robert-str/kicad_lib/struktura katalogu biblioteki.png

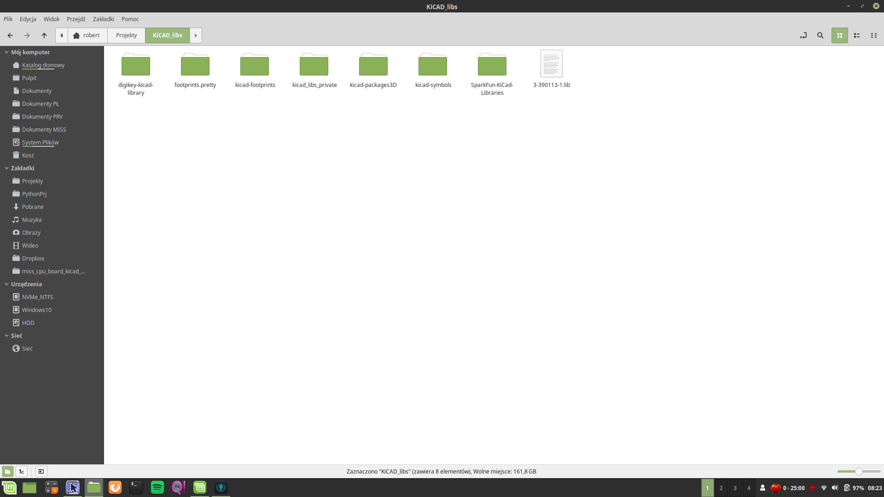
struktura katalogu biblioteki.png
