robert-str/kicad_lib/STEPs/TFBGA24025.step

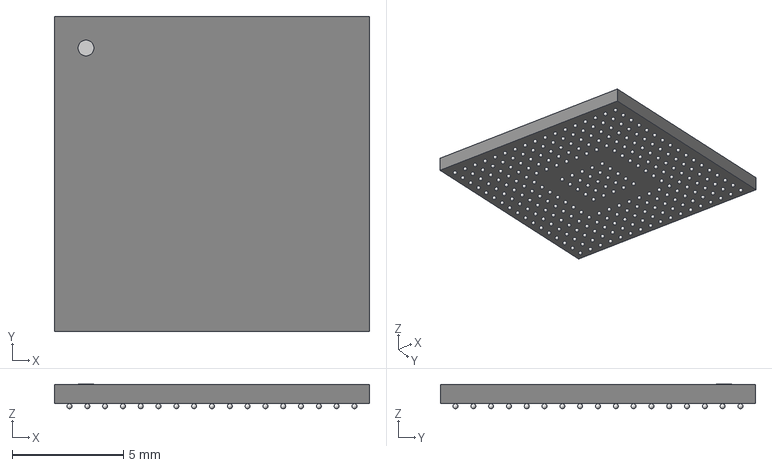
[picture p2: CAD file, 2022-11-16]
STEPs/TFBGA24025.step
14.1 x 14.1 x 1.10 mm
