robert-str/kicad_lib/STEPs/c-640456-5-aa-3d.stp

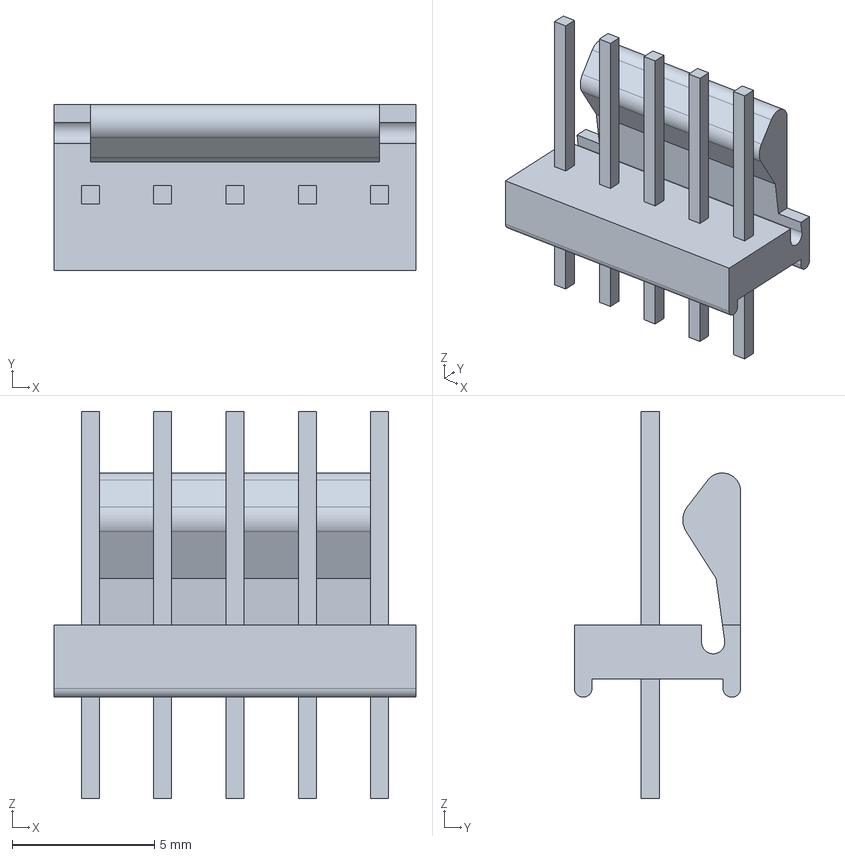
[picture p3: CAD file, 2022-11-16]
STEPs/c-640456-5-aa-3d.stp
12.7 x 5.84 x 13.6 mm
