robert-str/kicad_lib/STEPs/microphone_6mm_smt_h3i5mm.stp

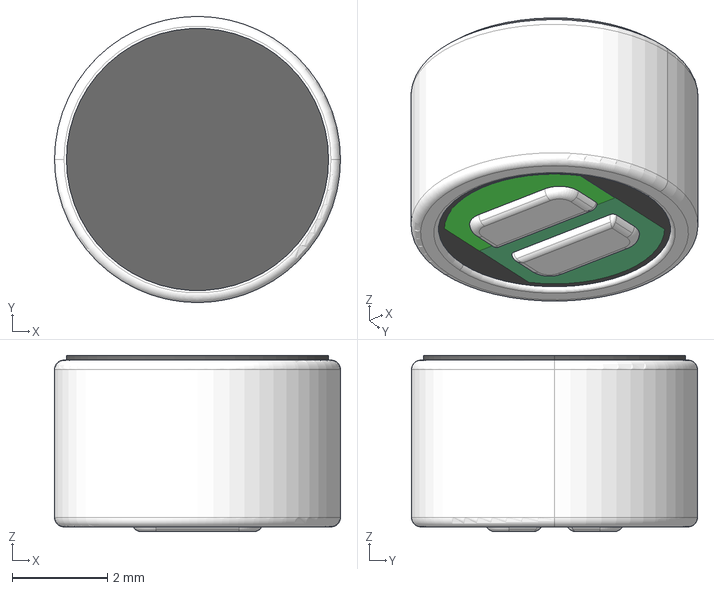
[picture p4: CAD file, 2022-11-16]
STEPs/microphone_6mm_smt_h3i5mm.stp
6.00 x 6.00 x 3.70 mm
