robert-str/kicad_lib/STEPs/QFN48_L-ASC10_ICE40ULTRA_PLUS__MACHXO2_LAT.step

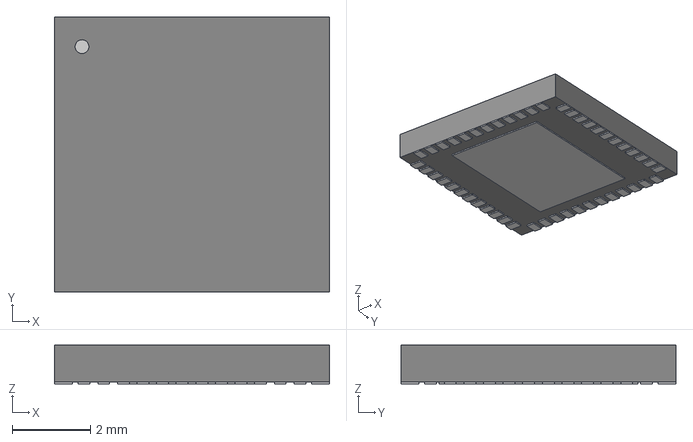
[picture p5: CAD file, 2022-11-16]
STEPs/QFN48_L-ASC10_ICE40ULTRA_PLUS__MACHXO2_LAT.step
7.01 x 7.01 x 0.993 mm
