robert-str/kicad_lib/STEPs/BRX1-0001.STEP

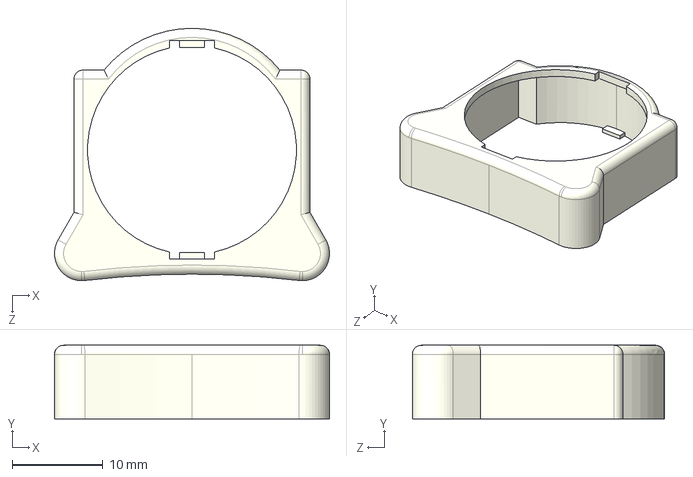
[picture p6: CAD file, 2022-11-16]
STEPs/BRX1-0001.STEP
30.3 x 8.10 x 27.8 mm
