robert-str/kicad_lib/STEPs/Crystal_ECX-32_3i2x2i5x0i8.STEP

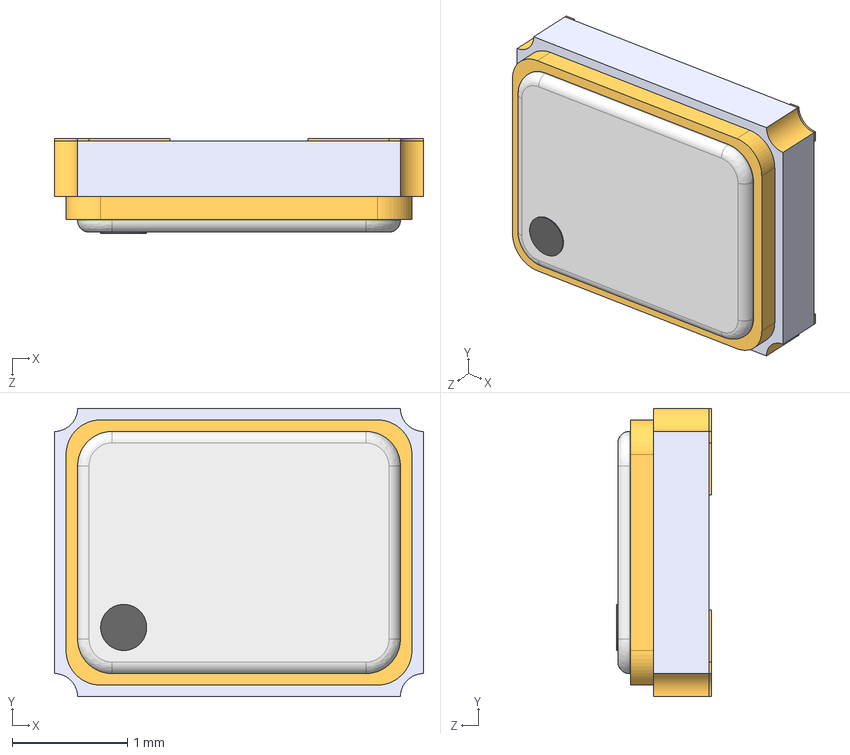
[picture p7: CAD file, 2022-11-16]
STEPs/Crystal_ECX-32_3i2x2i5x0i8.STEP
3.20 x 2.50 x 0.82 mm
MetalFrame
Pin1Marker
Pin3
Pin1
Lid
Pin4
Pin2
Ceramic
