robert-str/kicad_lib/STEPs/ASE_series _ABRACON.step

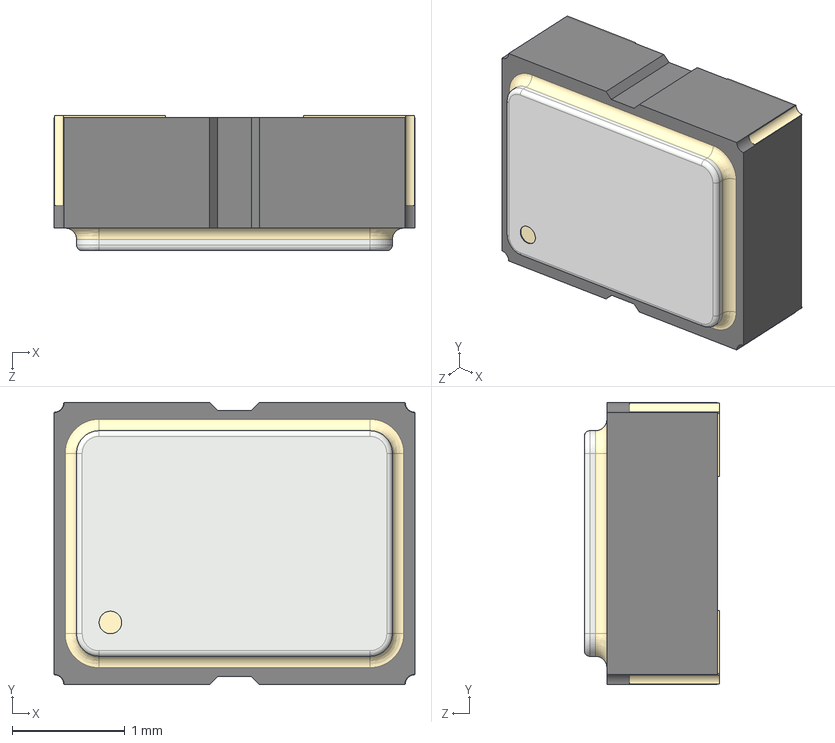
[picture p8: CAD file, 2022-11-16]
STEPs/ASE_series _ABRACON.step
3.20 x 2.50 x 1.20 mm
