robert-str/kicad_lib/STEPs/08B0-1X1T-06-F.step

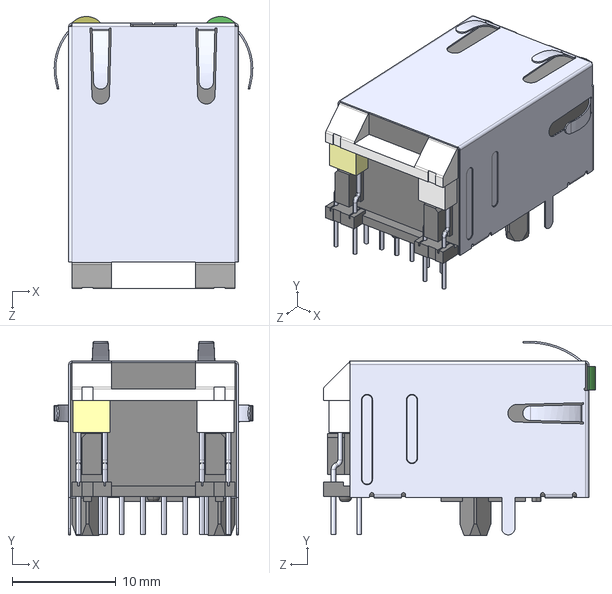
[picture p9: CAD file, 2022-11-16]
STEPs/08B0-1X1T-06-F.step
19.1 x 18.7 x 26.2 mm
