robert-str/kicad_lib/STEPs/BRX1-2477-SM.STEP

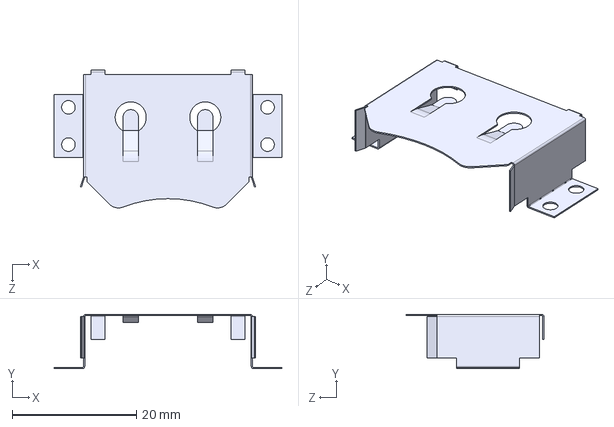
[picture p10: CAD file, 2022-07-14]
STEPs/BRX1-2477-SM.STEP
36.7 x 8.70 x 22.2 mm
