robert-str/kicad_lib/STEPs/Fuse_1812.step

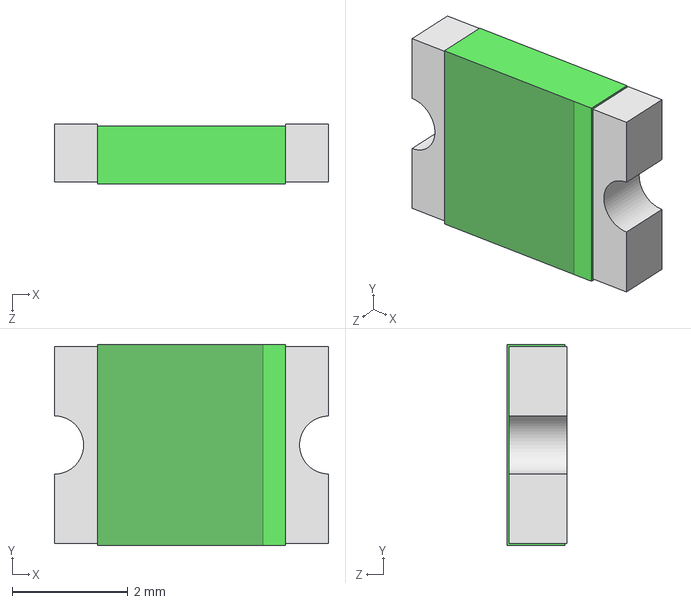
[picture p11: CAD file, 2022-07-14]
STEPs/Fuse_1812.step
4.74 x 3.48 x 1.04 mm
