robert-str/kicad_lib/STEPs/SOD-128_ST214.step

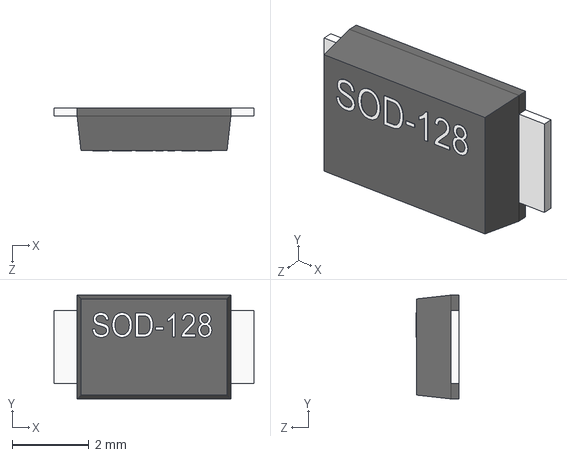
[picture p12: CAD file, 2022-07-14]
STEPs/SOD-128_ST214.step
5.20 x 2.70 x 1.11 mm
