robert-str/kicad_lib/STEPs/c-640456-2-aa-3d.stp

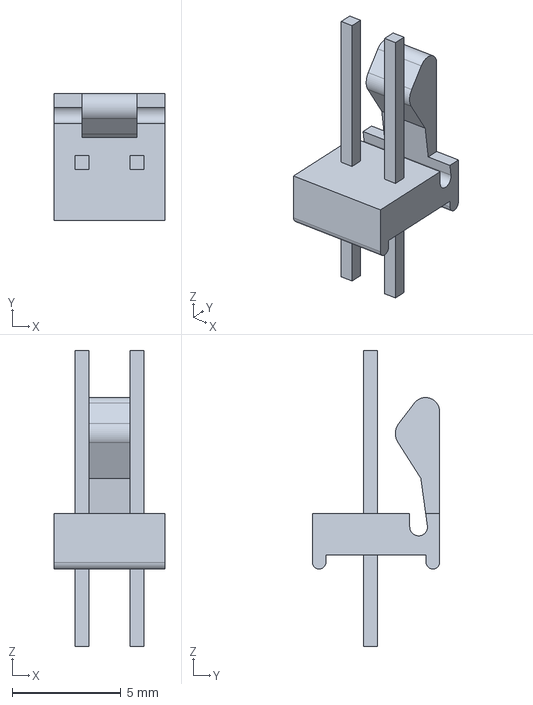
[picture p13: CAD file, 2022-07-14]
STEPs/c-640456-2-aa-3d.stp
5.08 x 5.84 x 13.6 mm
