robert-str/kicad_lib/STEPs/Coilcraft-MSS1210.step

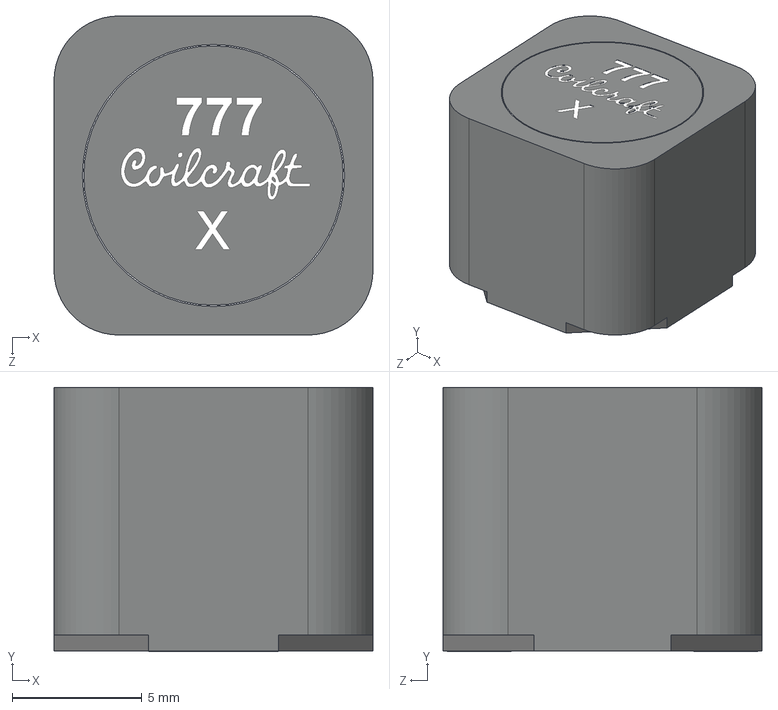
[picture p14: CAD file, 2022-07-14]
STEPs/Coilcraft-MSS1210.step
12.3 x 10.2 x 12.3 mm
