robert-str/kicad_lib/STEPs/CP_Elec_12.5x14_86508xx620xx (rev1).stp

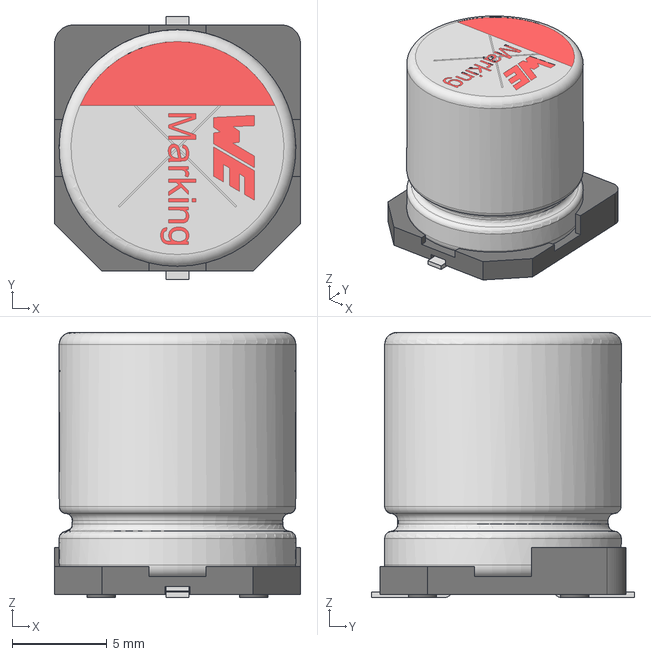
[picture p15: CAD file, 2022-07-14]
STEPs/CP_Elec_12.5x14_86508xx620xx (rev1).stp
13.0 x 13.9 x 14.0 mm
Base_Φ13Capacitor
capicitor_12.5x14x4.5
