robert-str/kicad_lib/STEPs/ABS09.STEP

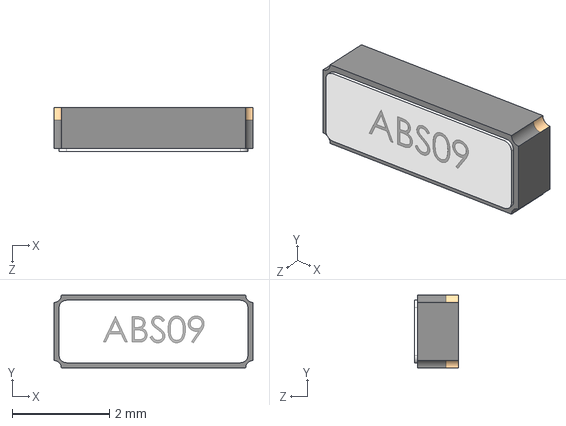
[picture p16: CAD file, 2022-05-02]
STEPs/ABS09.STEP
4.10 x 1.50 x 0.9 mm
