robert-str/kicad_lib/STEPs/XF3M_1015_1B.STEP

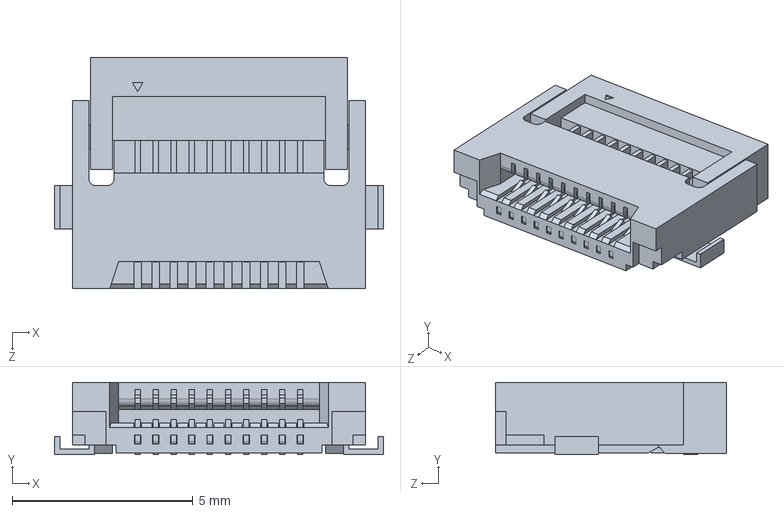
[picture p17: CAD file, 2022-05-02]
STEPs/XF3M_1015_1B.STEP
9.10 x 2.00 x 6.40 mm
