robert-str/kicad_lib/STEPs/XF2M_4015_1A.step

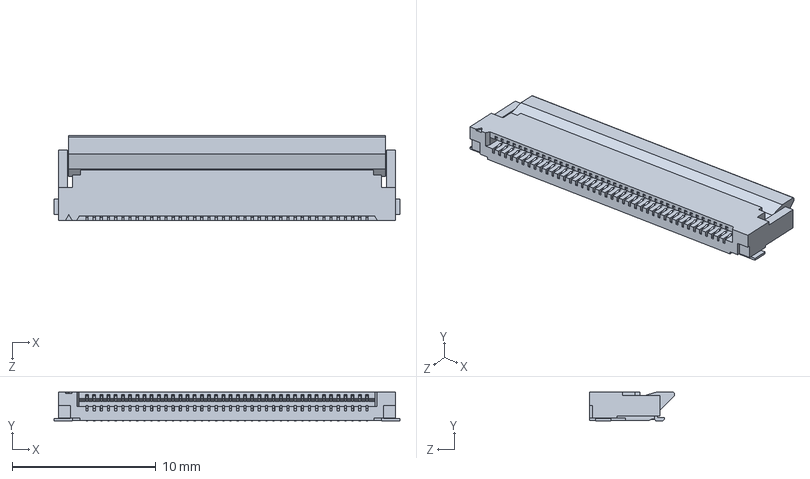
[picture p18: CAD file, 2022-05-02]
STEPs/XF2M_4015_1A.step
24.1 x 2.00 x 5.90 mm
