robert-str/kicad_lib/STEPs/XF2M_1015_1A.step

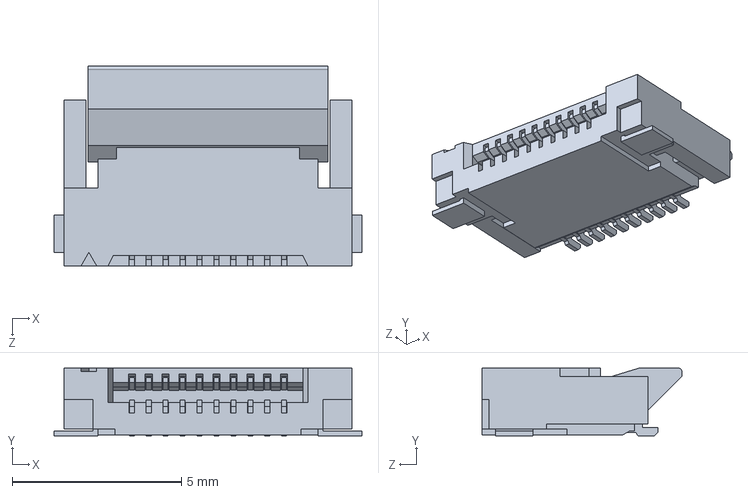
[picture p19: CAD file, 2022-05-02]
STEPs/XF2M_1015_1A.step
9.10 x 2.00 x 5.90 mm
