robert-str/kicad_lib/STEPs/OMRON B3U1000P.step

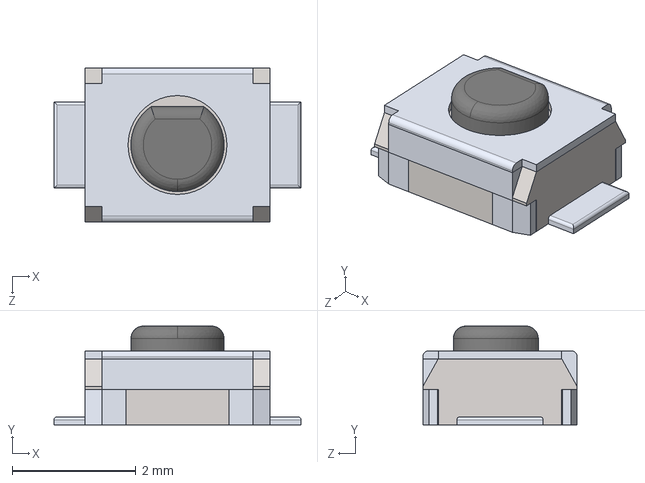
[picture p20: CAD file, 2021-01-22]
STEPs/OMRON B3U1000P.step
4.00 x 1.60 x 2.50 mm
