robert-str/kicad_lib/STEPs/MDBT50Q-U 3D Drawing_20180620.stp

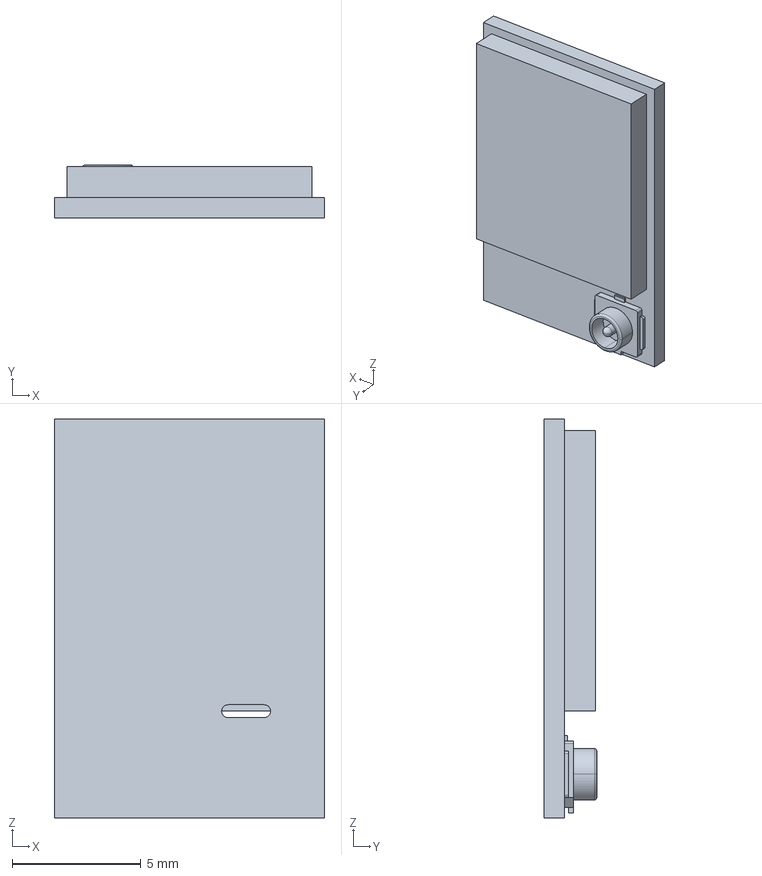
[picture p21: CAD file, 2019-12-09]
STEPs/MDBT50Q-U 3D Drawing_20180620.stp
10.5 x 2.05 x 15.5 mm
