robert-str/kicad_lib/STEPs/TSR-1.step

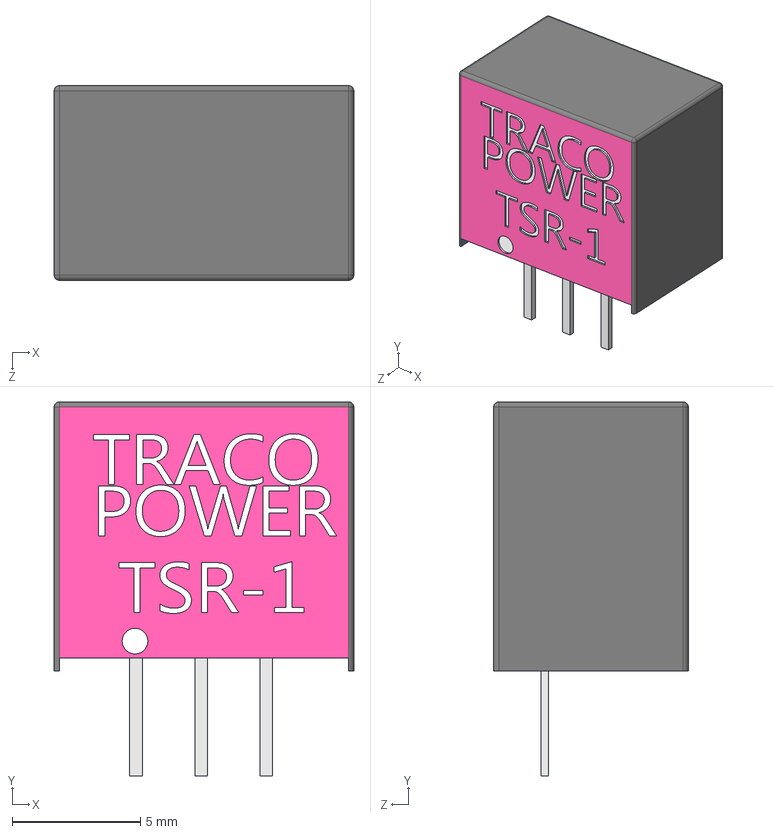
[picture p22: CAD file, 2019-12-09]
STEPs/TSR-1.step
11.7 x 14.6 x 7.60 mm
