robert-str/kicad_lib/STEPs/TSR-2.step

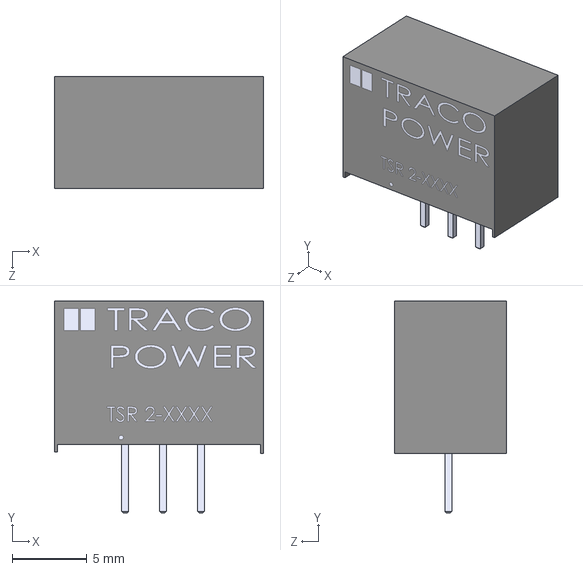
[picture p23: CAD file, 2019-12-09]
STEPs/TSR-2.step
14.0 x 14.2 x 7.50 mm
