robert-str/kicad_lib/STEPs/KEYSTONE 2460.step

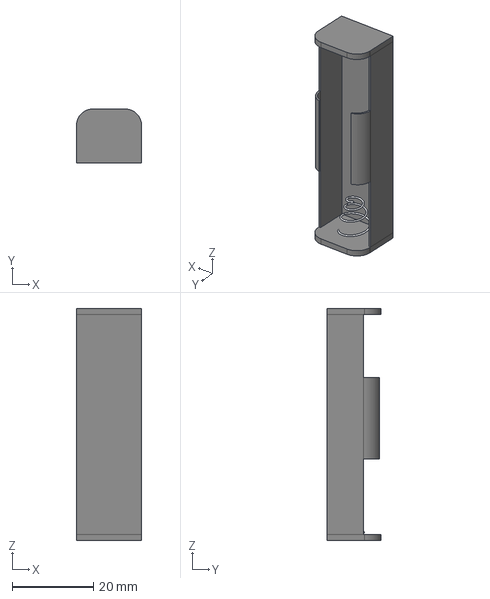
[picture p24: CAD file, 2019-12-09]
STEPs/KEYSTONE 2460.step
16.0 x 13.3 x 57.0 mm
