robert-str/kicad_lib/STEPs/SM1X91_body.stp

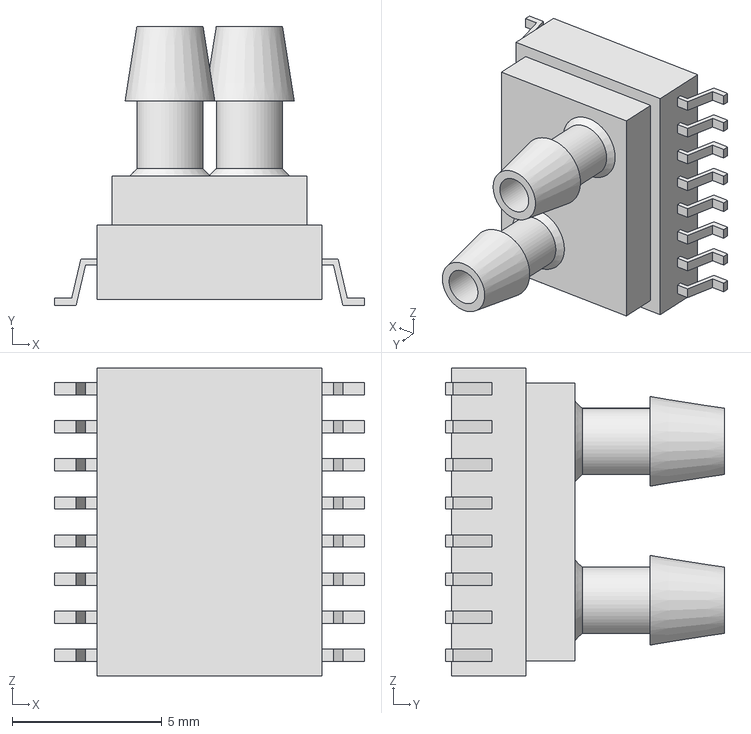
[picture p25: CAD file, 2019-12-09]
STEPs/SM1X91_body.stp
10.3 x 9.32 x 10.3 mm
