robert-str/kicad_lib/STEPs/RJHSE-X38X-REVT1.STEP

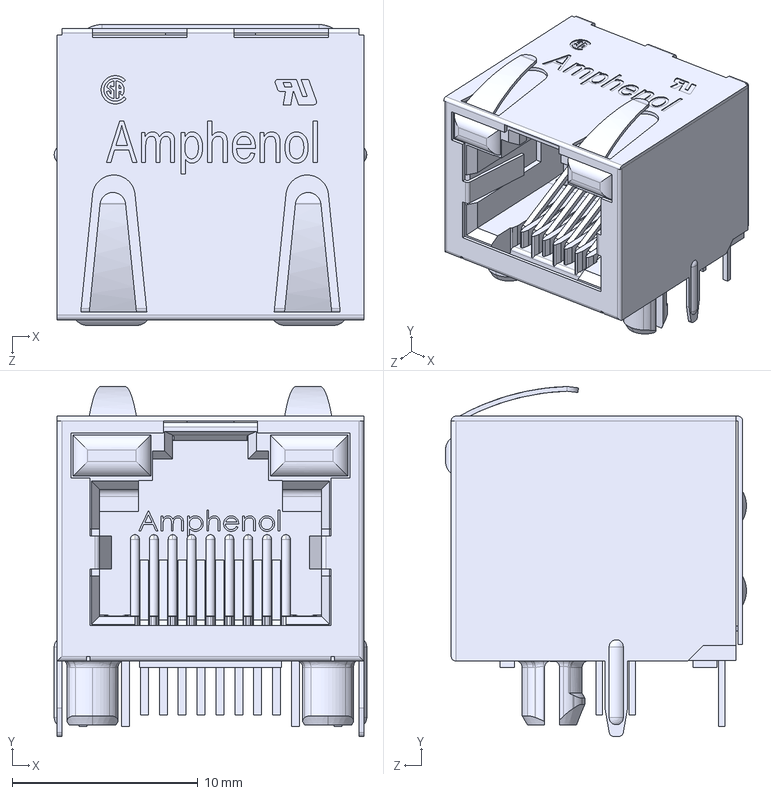
[picture p26: CAD file, 2019-11-26]
STEPs/RJHSE-X38X-REVT1.STEP
16.8 x 18.8 x 16.2 mm
