robert-str/kicad_lib/STEPs/MX-48037-0001.STEP

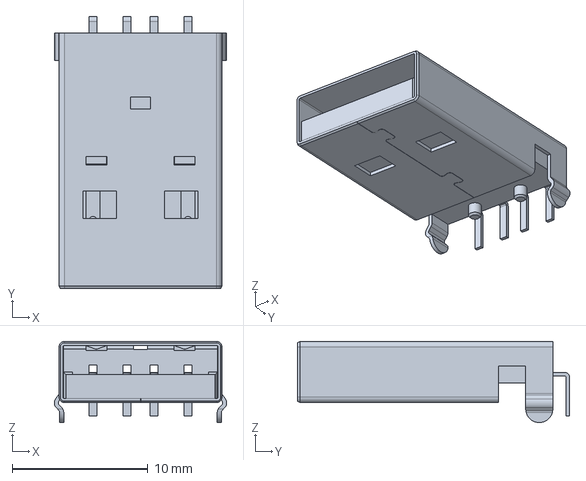
[picture p27: CAD file, 2019-11-26]
STEPs/MX-48037-0001.STEP
12.7 x 20.0 x 5.97 mm
