robert-str/kicad_lib/STEPs/Conn_Pancon_MLSS100-2-D_eec.STEP

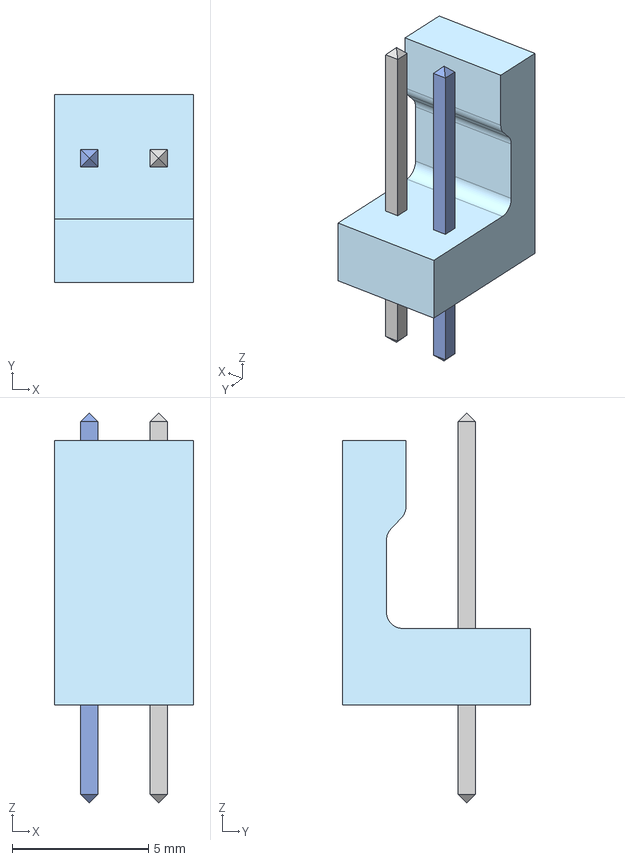
[picture p28: CAD file, 2019-11-14]
STEPs/Conn_Pancon_MLSS100-2-D_eec.STEP
5.10 x 6.90 x 14.3 mm
