robert-str/kicad_lib/STEPs/UE27-AEX4-X0X-REVT2.STEP

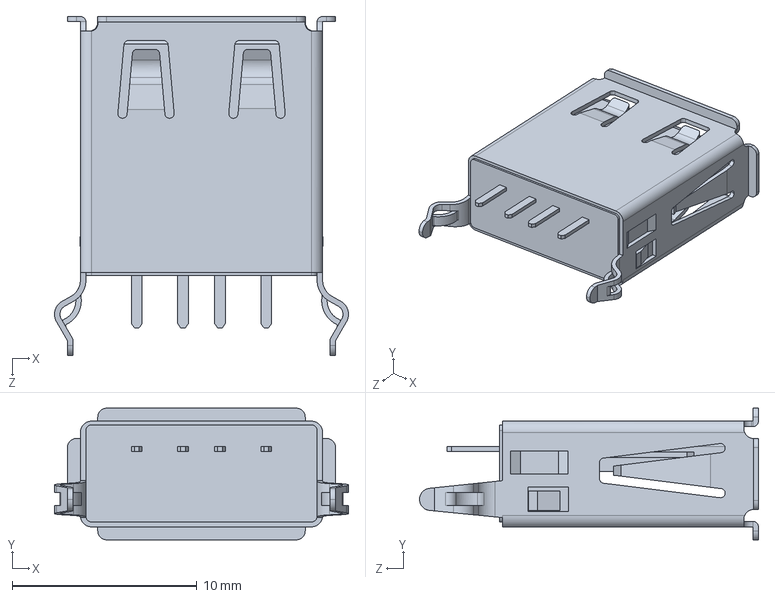
[picture p29: CAD file, 2019-11-14]
STEPs/UE27-AEX4-X0X-REVT2.STEP
15.9 x 7.12 x 18.3 mm
