robert-str/kicad_lib/STEPs/DG300-5_0-02P-12.step

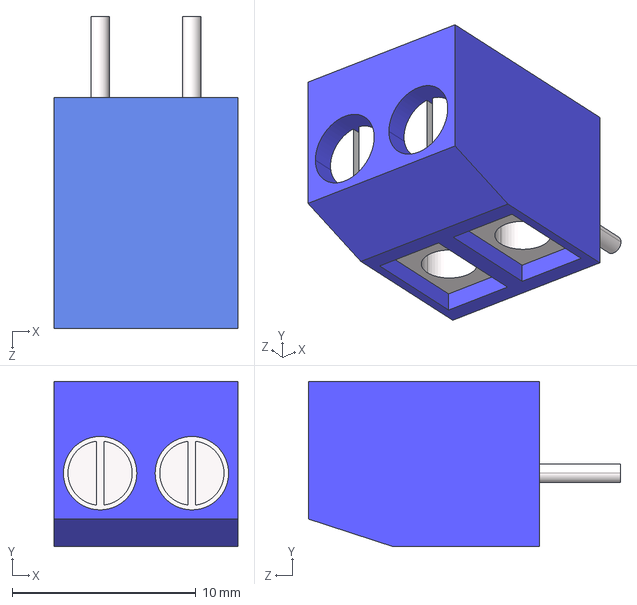
[picture p30: CAD file, 2019-09-20]
STEPs/DG300-5_0-02P-12.step
10.0 x 9.00 x 17.0 mm
