robert-str/kicad_lib/STEPs/STEP-WE-CBF-0603-rev1.stp

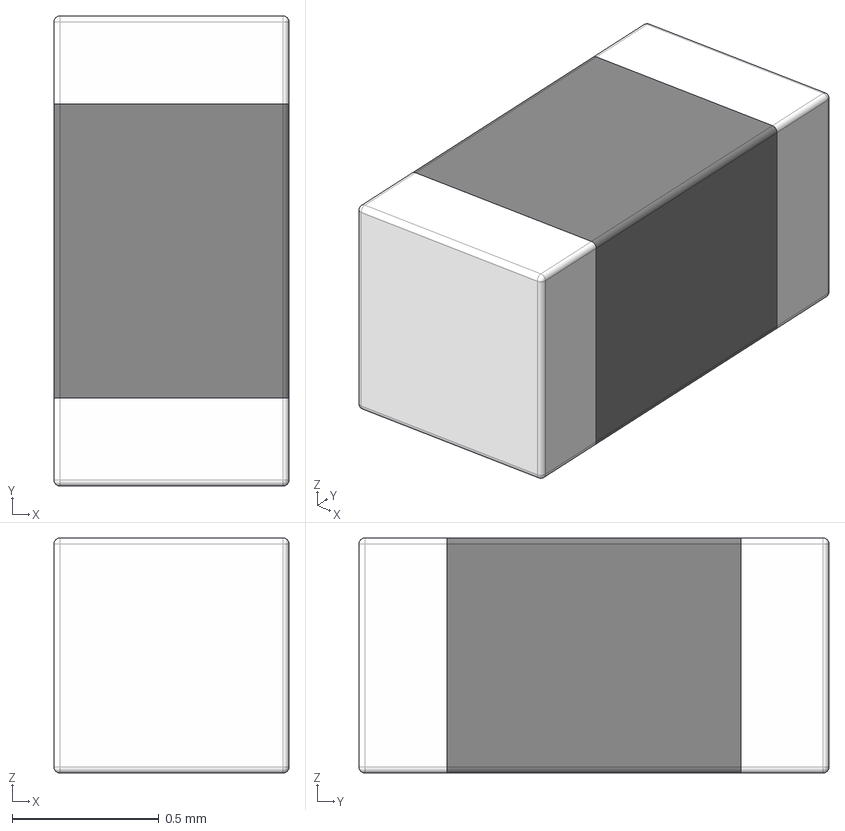
[picture p31: CAD file, 2019-09-19]
STEPs/STEP-WE-CBF-0603-rev1.stp
0.8 x 1.60 x 0.8 mm
