robert-str/kicad_lib/STEPs/STEP-WE-TMSB-0402-rev1.stp

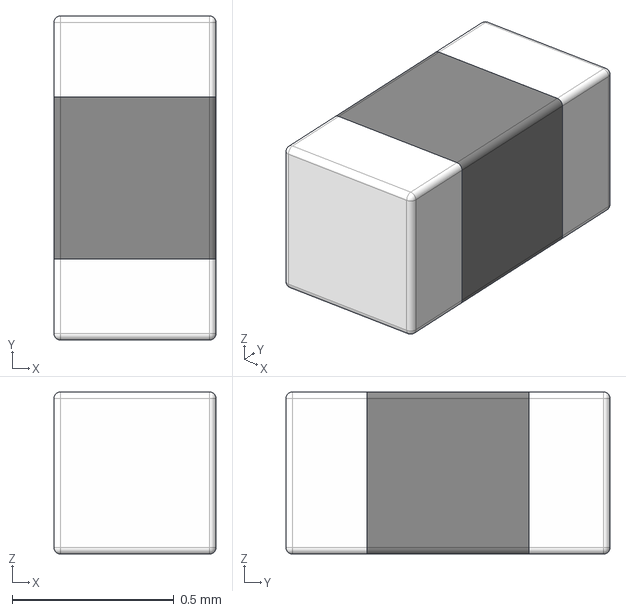
[picture p32: CAD file, 2019-08-29]
STEPs/STEP-WE-TMSB-0402-rev1.stp
0.5 x 1.00 x 0.5 mm
Lötende x 2
