robert-str/kicad_lib/STEPs/DFN-8-1EP_3x2mm_P0.5mm_EP1.3x1.5mm.step

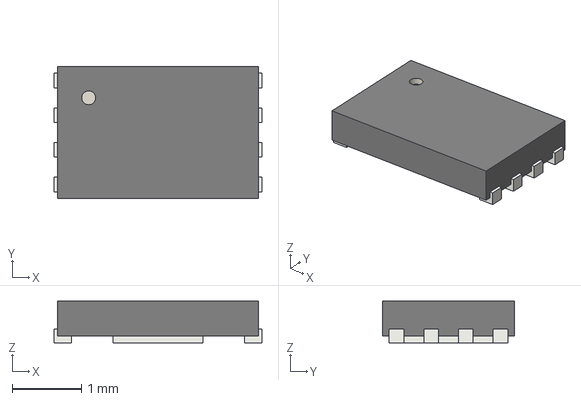
[picture p33: CAD file, 2019-08-29]
STEPs/DFN-8-1EP_3x2mm_P0.5mm_EP1.3x1.5mm.step
3.00 x 1.90 x 0.6 mm
