robert-str/kicad_lib/STEPs/User Library-BGA 24.STEP

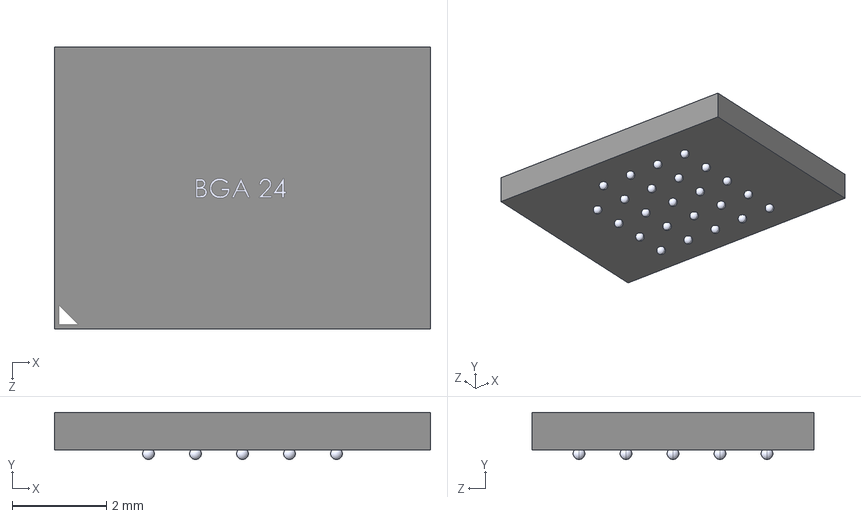
[picture p34: CAD file, 2019-08-29]
STEPs/User Library-BGA 24.STEP
8.00 x 1.00 x 6.00 mm
