robert-str/kicad_lib/STEPs/ABS07.STEP

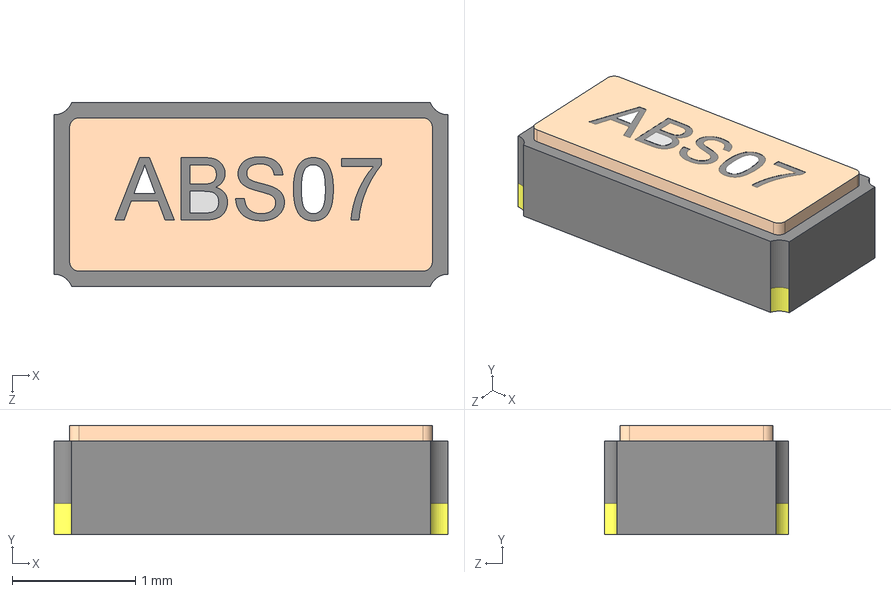
[picture p35: CAD file, 2019-08-29]
STEPs/ABS07.STEP
3.20 x 0.889 x 1.50 mm
