robert-str/kicad_lib/STEPs/MLSS156-2-D.STEP

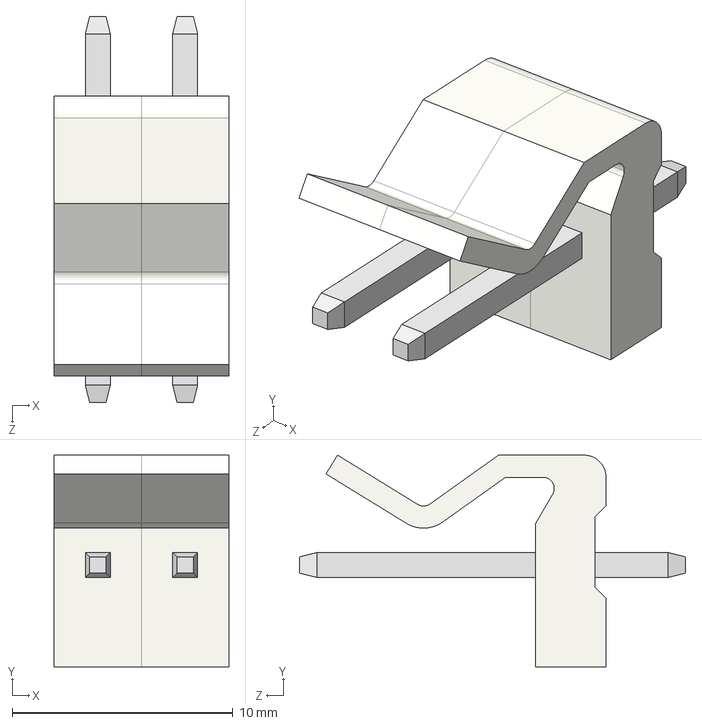
[picture p36: CAD file, 2019-08-29]
STEPs/MLSS156-2-D.STEP
7.92 x 9.60 x 17.5 mm
User Library-Cvilux_CI5102P1V00_BASE x 2
User Library-Cvilux_CI5102P1V00_pin x 2
