robert-str/kicad_lib/STEPs/MLSS100-4-D.stp

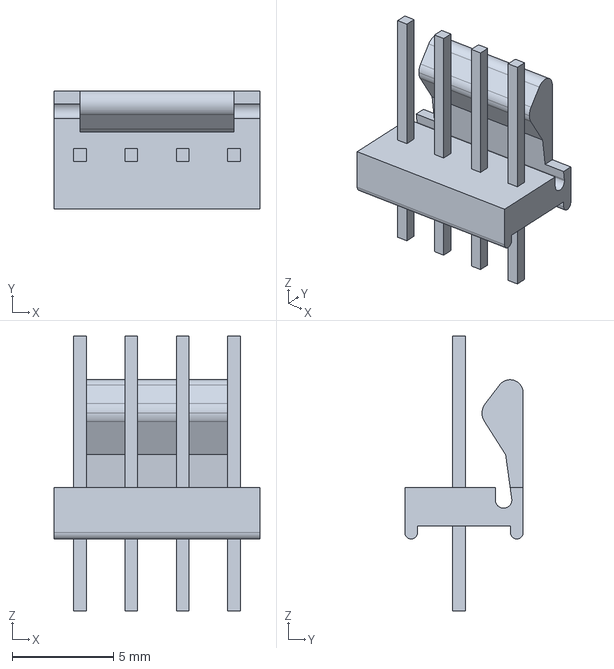
[picture p37: CAD file, 2019-08-29]
STEPs/MLSS100-4-D.stp
10.2 x 5.84 x 13.6 mm
