robert-str/kicad_lib/STEPs/TF-BGA54.step

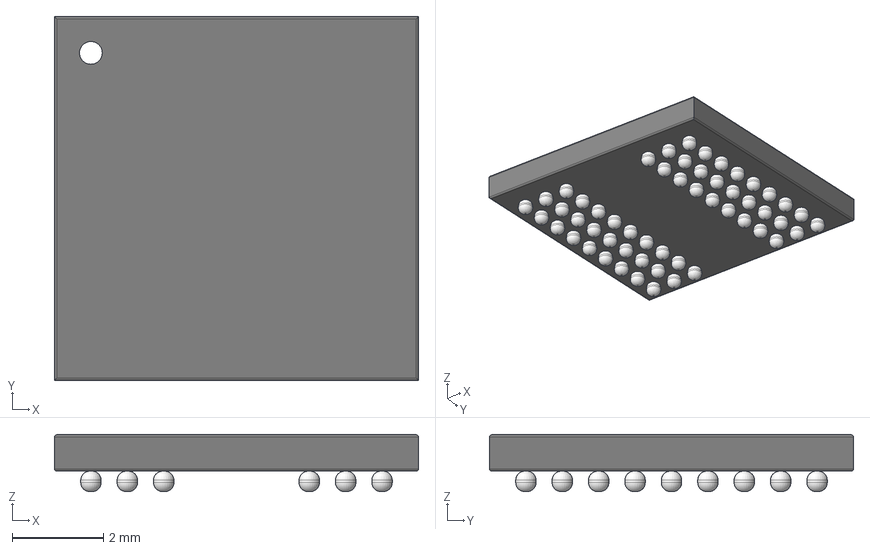
[picture p38: CAD file, 2019-08-29]
STEPs/TF-BGA54.step
8.00 x 8.00 x 1.28 mm
Left_Right_Balls
Left_Array
Body_formed
A1_PIN
