robert-str/kicad_lib/STEPs/VSON-N8.STEP

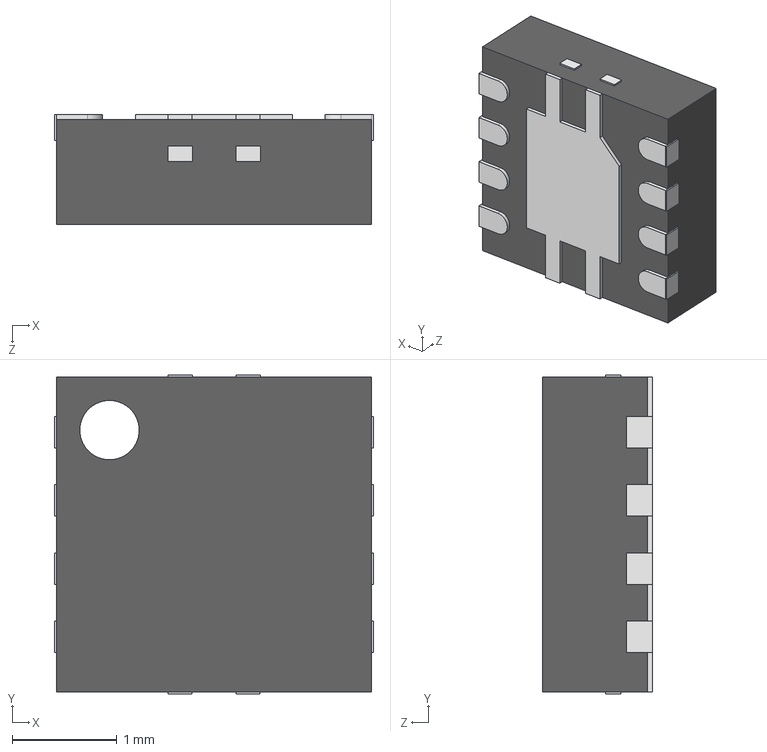
[picture p39: CAD file, 2019-08-29]
STEPs/VSON-N8.STEP
3.04 x 3.04 x 1.05 mm
