robert-str/kicad_lib/STEPs/User Library-TDFN-8-1.STEP

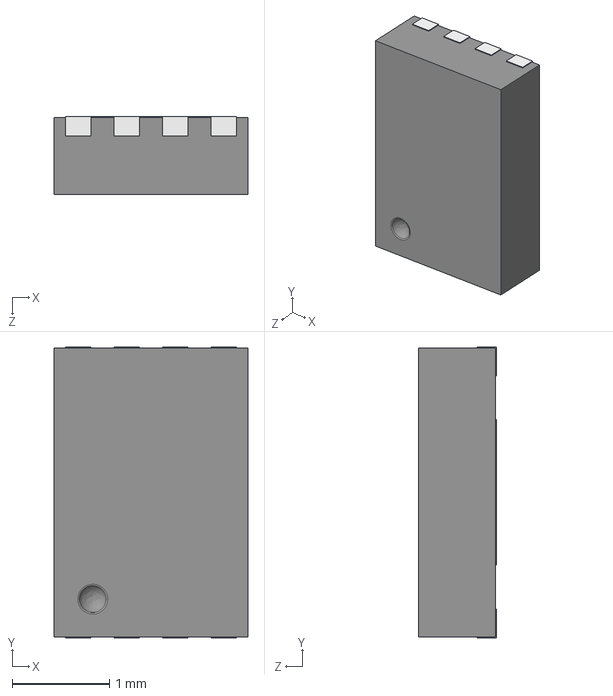
[picture p40: CAD file, 2019-08-29]
STEPs/User Library-TDFN-8-1.STEP
2.00 x 3.00 x 0.8 mm
User Library-TDFN-8-1_Fillet
User Library-TDFN-8-1_Fusion
