robert-str/kicad_lib/STEPs/User Library-CFPT-9301.step

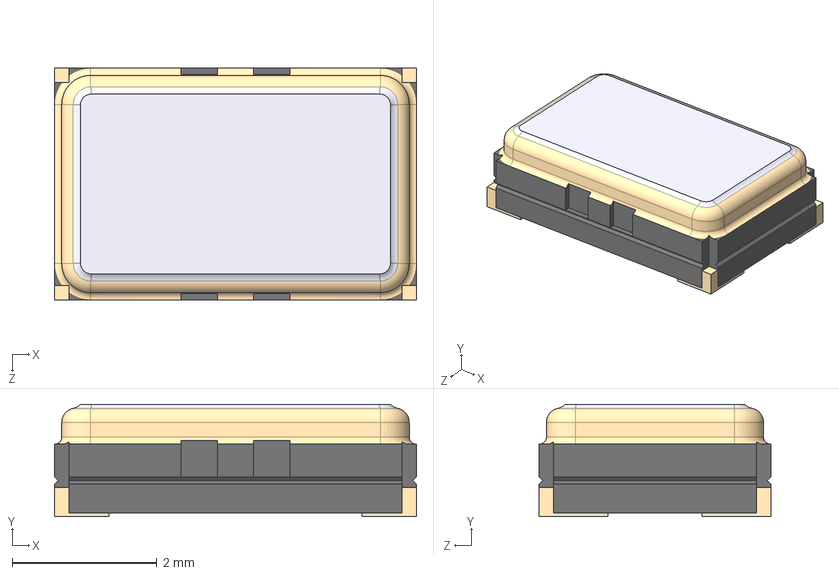
[picture p41: CAD file, 2019-08-29]
STEPs/User Library-CFPT-9301.step
5.00 x 1.55 x 3.20 mm
