robert-str/kicad_lib/(list of files, cad)

Other CAD files:
STEPs/BGA24_5X5_6X8mm_Pitch1.0mm.STEP
STEPs/1734366-1-c1-3d.stp
STEPs/52207-1085.stp
STEPs/52745-1096.stp
STEPs/61201620621_rev1.stp
STEPs/61202420621_rev1.stp
STEPs/670689000.stp
STEPs/676430910.stp
STEPs/68711014022 (rev1).stp
STEPs/68711014522.stp
STEPs/68714014522 (rev1).stp
STEPs/687310124422.stp
STEPs/687340124422 (rev1).stp
STEPs/690357281876 (rev1).stp
STEPs/690357282076 (rev1).stp
STEPs/690367291876 (rev1).stp
STEPs/690367292076 (rev1).stp
STEPs/74279224551.stp
STEPs/7499010121A (rev1).stp
STEPs/84596VCNL3020.stp
STEPs/936273608.stp
