robert-str/kicad_lib/(commit log)

2019-08-29 initial commit
    1. add base components for RK project
    [68711014022 (rev1).stp, 68711014522 (rev1).stp, 68714014522 (rev1).stp, 687340124422 (rev1).stp, ABS07.STEP, BGA24_5X5_6X8mm_Pitch1.0mm.STEP, DFN-8-1EP_3x2mm_P0.5mm_EP1.3x1.5mm.step, MLSS100-4-D.stp]
2019-08-30 catalog file structure printscreen
2019-09-09 update from LUT
    [52207-1085.stp, 52745-1096.stp, STEP-WE-CBF-0603-rev1.stp]
2019-09-20 MRI COILS v1 project - some elements
    [DG300-5_0-02P-12.step]
2019-09-22 components for coils driver & array - v1
2019-10-15 Elementy do SCH/PCB BASE_BOARD_ALFA
2019-11-05 BASE board footprints added - part
2019-11-06 added MISS new logos and FFC connector
    [68711014522.stp, 687310124422.stp]
2019-11-14 added footprint for usbkey USB A plug
2019-11-14 new footprints for IO board
    [1734366-1-c1-3d.stp, Conn_Pancon_MLSS100-2-D_eec.STEP, UE27-AEX4-X0X-REVT2.STEP]
2019-11-20 TDA audio from Texas + pressure sensor SCH + PCB
2019-11-26 added footprints for I/O horizontal board
    [676430910.stp, MX-48037-0001.STEP, RJHSE-X38X-REVT1.STEP]
2019-11-26 added footprints fot USB circuit
2019-12-09 update of footprints for BASE BOARD
    [61201620621_rev1.stp, 61202420621_rev1.stp, 74279224551.stp, KEYSTONE 2460.step, SM1X91_body.stp, TSR-1.step, TSR-2.step]
2020-11-02 Update 102020
    [OMRON B3U1000P.step]
2020-11-08 UPdate MCP1755(S)/MCP1703
    1.8V LDO voltage stabilizer update
2020-11-12 Update of connectors
    4 programming interface
2020-12-01 update integrated circuits
2021-01-22 up diode
2021-01-23 new hole for io board
2021-01-26 added SMT connector 2x10 IDC
2021-01-26 ICD 2x10 2,54mm pitch SMT 4 BASE EUP
2021-01-27 Routing stage
2021-02-05 OMRON FFC (10 & 40pin, 0.5mm pitch) for EUP BASE CHARLIE to old LCD
2021-02-06 add footprint
2022-05-02 Update after MOTOR & VAC modules
    - before conversion SCH libs to KiCad 6.0 version
    [690357281876 (rev1).stp, 690357282076 (rev1).stp, 690367291876 (rev1).stp, 690367292076 (rev1).stp, 84596VCNL3020.stp, ABS09.STEP, XF2M_1015_1A.step, XF2M_4015_1A.step]
2022-07-14 update before BIO v2
    [7499010121A (rev1).stp, BRX1-2477-SM.STEP, CP_Elec_12.5x14_86508xx620xx (rev1).stp, Coilcraft-MSS1210.step, Fuse_1812.step, SOD-128_ST214.step, c-640456-2-aa-3d.stp]
2022-11-16 update 11.2022
    after MCU v2.0
    [08B0-1X1T-06-F.step, 936273608.stp, ASE_series _ABRACON.step, BRX1-0001.STEP, Crystal_ECX-32_3i2x2i5x0i8.STEP, QFN48_L-ASC10_ICE40ULTRA_PLUS__MACHXO2_LAT.step, TFBGA24025.step, c-640456-5-aa-3d.stp]
2022-12-15 Update after BIO programmer
    [670689000.stp]
2023-01-12 adding footprints for BIO-RC
2023-01-15 Atnena for BIO RC v1 footprint
2023-01-15 footprints for RC BIO v0.1 updated
